xzlashutosh/avsddac_3v3/README.md

## 1. Introduction to Potentiometric Digital to Analog Converter
This repository presents a 10-bit Potentiometric Digital to Analog Converter.

The target is to design a 10-bit potentiometric DAC with 3.3v analog voltage and 1 off-chip external reference using the osu180nm technology node. Here are the specifications from [VSD Corporation Pvt. Ltd.](https://github.com/xzlashutosh/avsddac_3v3/blob/master/potentiometricDAC_IP.pdf)

A DAC is a building block required to convert digital data into analog.

## Table of Contents
- [1. Introduction to Potentiometric Digital to Analog Converter](#1-introduction-to-potentiometric-digital-to-analog-converter)
- [2. Potentiometric DAC Architecture Design](#2-potentiometric-dac-architecture-design)
- [3. Specification List](#3-specification-list)
- [4. EDA Tools Used](#4-eda-tools-used)
- [5. Pre-layout and Simulations](#5-pre-layout-and-simulations)
  * [A. Switch](#a-switch)
  * [B. 2-Bit DAC subcircuit](#b-2-bit-dac-subcircuit)
  * [C. 3-Bit DAC subcircuit](#c-3-bit-dac-subcircuit)
  * [D. 4-Bit DAC subcircuit](#d-4-bit-dac-subcircuit)
  * [E. 5-Bit DAC subcircuit](#e-5-bit-dac-subcircuit)
  * [F. 6-Bit DAC subcircuit](#f-6-bit-dac-subcircuit)
  * [G. 7-Bit DAC subcircuit](#g-7-bit-dac-subcircuit)
  * [H. 8-Bit DAC subcircuit](#h-8-bit-dac-subcircuit)
  * [I. 9-Bit DAC subcircuit](#i-9-bit-dac-subcircuit)
  * [J. 10-Bit-DAC](#j-10-bit-dac)
  * [Vout v/s Digital Code Graph for 10-Bit DAC](https://github.com/xzlashutosh/avsddac_3v3#vout-vs-digital-code-graph-for-10-bit-dac)
  * [INL(LSB) v/s Digital Code Graph for 10-Bit DAC](https://github.com/xzlashutosh/avsddac_3v3#inllsb-vs-digital-code-graph-for-10-bit-dac)
  * [DNL(LSB) v/s Digital Code Graph for 10-Bit DAC](https://github.com/xzlashutosh/avsddac_3v3#dnllsb-vs-digital-code-graph-for-10-bit-dac)
- [6. Layout and Simulations](#6-layout-and-simulations)
  * [A. Switch Layout](#a-switch-layout)
  * [B. Resistor Layout](#b-resistor-layout)
  * [C. Capacitor Layout](#c-capacitor-layout)
    + [Modification done in osu180nm to make use of a capacitor as a device -](#modification-done-in-osu180nm-to-make-use-of-a-capacitor-as-a-device--)
    + [Limitation of osu180 PDK -](#limitation-of-osu180-pdk--)
  * [D. 2-Bit DAC Subcircuit Layout](#d-2-bit-dac-subcircuit-layout)
  * [E. 3-Bit DAC Subcircuit Layout](#e-3-bit-dac-subcircuit-layout)
  * [F. 4-Bit DAC Subcircuit Layout](#f-4-bit-dac-subcircuit-layout)
  * [G. 5-Bit DAC Subcircuit Layout](#g-5-bit-dac-subcircuit-layout)
  * [H. 6-Bit DAC Subcircuit Layout](#h-6-bit-dac-subcircuit-layout)
  * [I. 7-Bit DAC Subcircuit Layout](#i-7-bit-dac-subcircuit-layout)
  * [J. 8-Bit DAC Subcircuit Layout](#j-8-bit-dac-subcircuit-layout)
  * [K. 9-Bit DAC Subcircuit Layout](#k-9-bit-dac-subcircuit-layout)
  * [L. 10-Bit-DAC Layout](#l-10-bit-dac-layout)
  * [Vout v/s Digital Code Graph for 10-Bit DAC](#vout-v-s-digital-code-graph-for-10-bit-dac-1)
  * [INL(LSB) v/s Digital Code Graph for 10-Bit DAC](#inl-lsb--v-s-digital-code-graph-for-10-bit-dac-1)
  * [DNL(LSB) v/s Digital Code Graph for 10-Bit DAC](#dnl-lsb--v-s-digital-code-graph-for-10-bit-dac-1)
- [7. Instructions to get started with the design](#7-instructions-to-get-started-with-the-design)
  * [For Pre-Layout Simulation -](#for-pre-layout-simulation--)
  * [For Post-Layout Simulation -](#for-post-layout-simulation--)
- [8. Author](#8-author)
- [9. Acknowledgments](#9-acknowledgments)
- [10. Contact Information -](#10-contact-information--)

## 2. Potentiometric DAC Architecture Design

The basic idea is to divide the voltage into N different voltage values in the range of Vref+ and Vref- for an N-Bit DAC. The design used here to achieve this is the simple resistor string DAC which consists of resistors in series. These resistors are then connected to various switches in such a fashion that it routes the exact voltage to the output.

The problem of the largeness of the circuit is reduced by building hierarchical subcircuits of switch, 2 Bit, 3 Bit, 4 Bit,....., 9 Bit DAC, and then two 9 Bit DAC is used to build the 10-Bit potentiometric DAC.

Have a look at the simplified architecture for potentiometric-DAC given below

<p align="center">
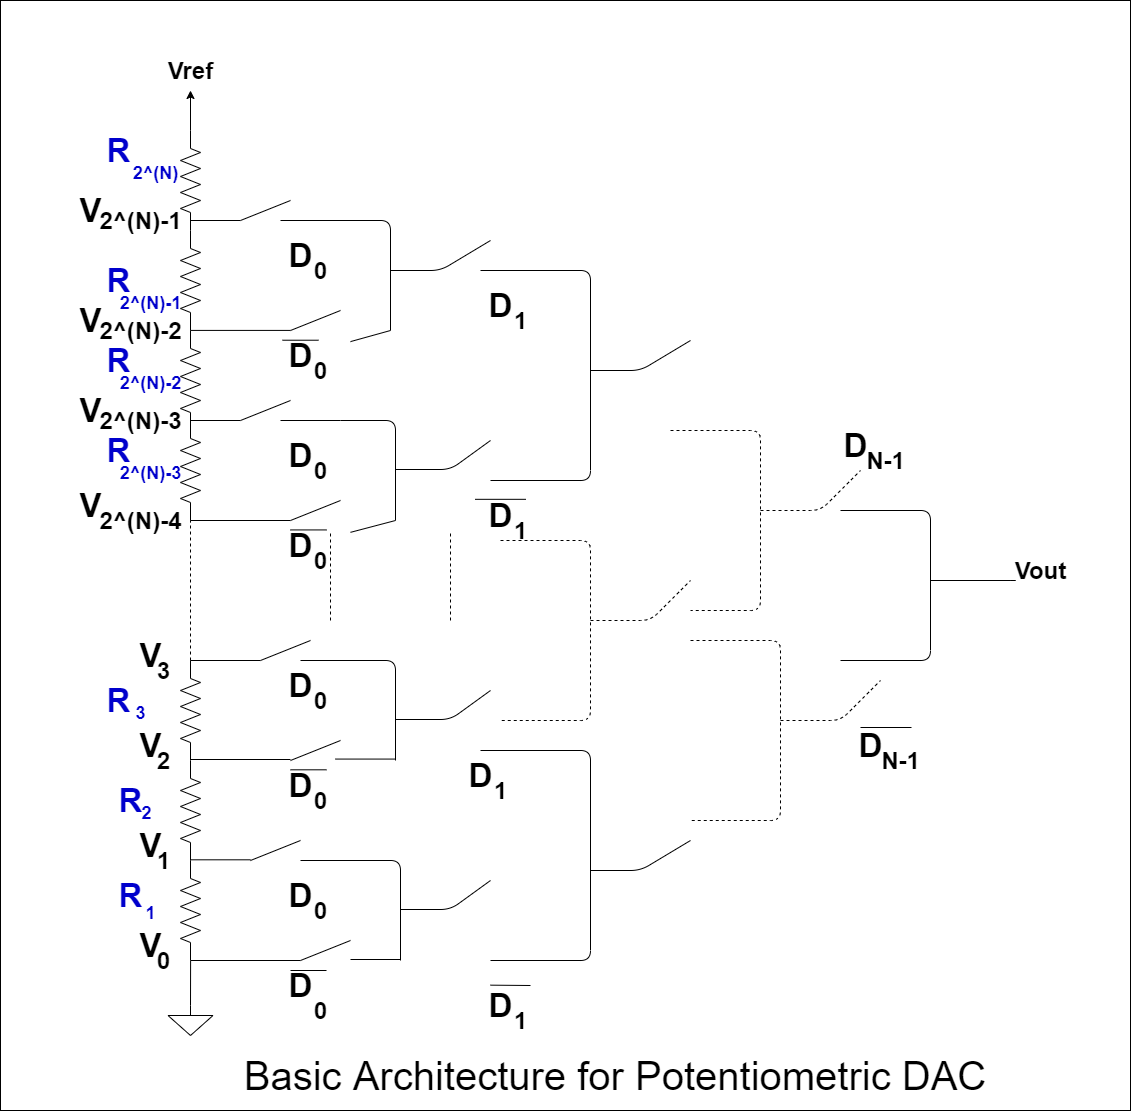
[picture p1: subcircuits/An overview of 10-Bit PotDAC.png]
  
</p>

Given below is the block diagram of the DAC - 

<p align="center">
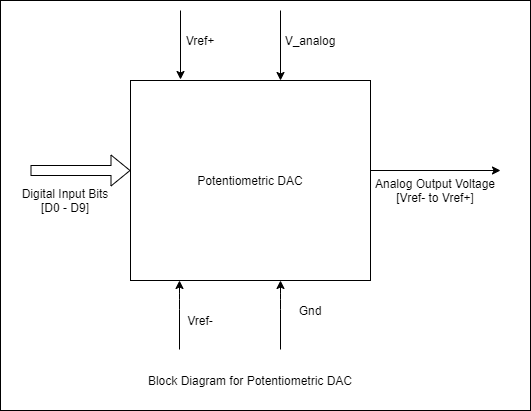
[picture p2: subcircuits/overview of design.png]
  
</p>

## 3. Specification List

| Parameter| Description| Min | Type | Max | Unit | Condition |
| :---:  | :-: | :-: | :-: | :---:  | :-: | :-: |
|RL|Load resistance| 50|||Mohm|T=-40 to 85C|
|CL|Load capacitance|||1|pF|T=-40 to 85C|
|VDDA|Analog supply| |3.3||V|T=-40 to 85C|
|VDD|Digital supply voltage||1.8||V|T=-40 to 85C|
|VREFH|Reference voltage high|||3.3|V|T=-40 to 85C|
|VREFL|Reference voltage low|0|||V|T=-40 to 85C|
|RES|Resolution| |10||bit|T=27C|
|VFS|Full Scale Voltage|0| |3.291627| V |T=27C|

| Parameter| Pre-layout | Post-Layout |
| :---:  | :-: | :-: |
|DNL| -0.999893345 LSB to 2.03065020 LSB | -1.182952606 LSB to 2.380283181 LSB |
|INL| -1.953038429 LSB to 0.527216491 LSB| -3.698306813 LSB to 0.181125461 LSB |
|Gain Error| 0 | 0 |
|Offset Error| 2.12E-07 V | 2.14E-07 V |

## 4. EDA Tools Used 
The design has been built using open-source EDA tools. The library used is osu180nm. 

I have used [eSim](https://esim.fossee.in/downloads) to build schematic, [ngSpice](http://ngspice.sourceforge.net/download.html) to run simulations and verify the circuit. [Magic](http://opencircuitdesign.com/magic/) has been used to lay-out the circuit.

## 5. Pre-layout and Simulations
The complete circuit of 10-Bit potentiometric DAC is built hierarchically using the following subcircuits.

### A. Switch
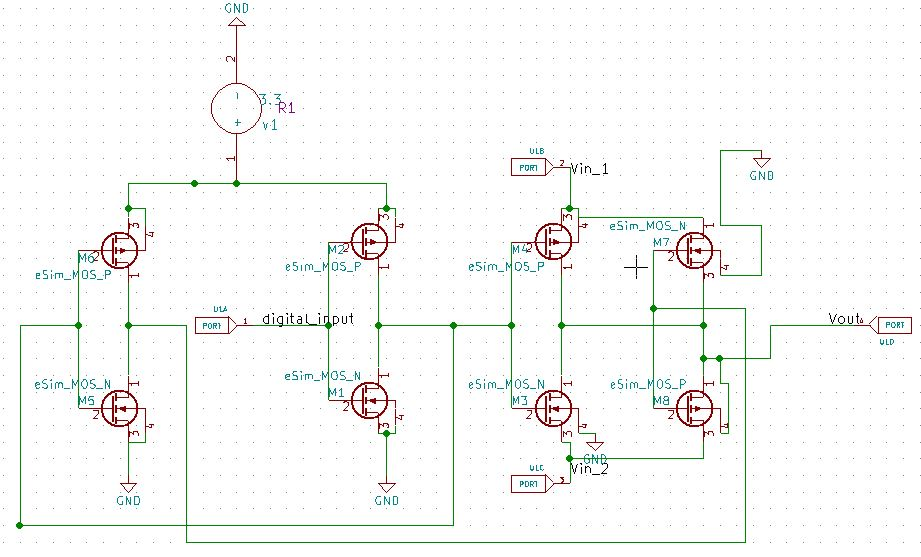
[picture p3: Pre-Layout and Simulation/Switch - prelayout.JPG]


### B. 2-Bit DAC subcircuit
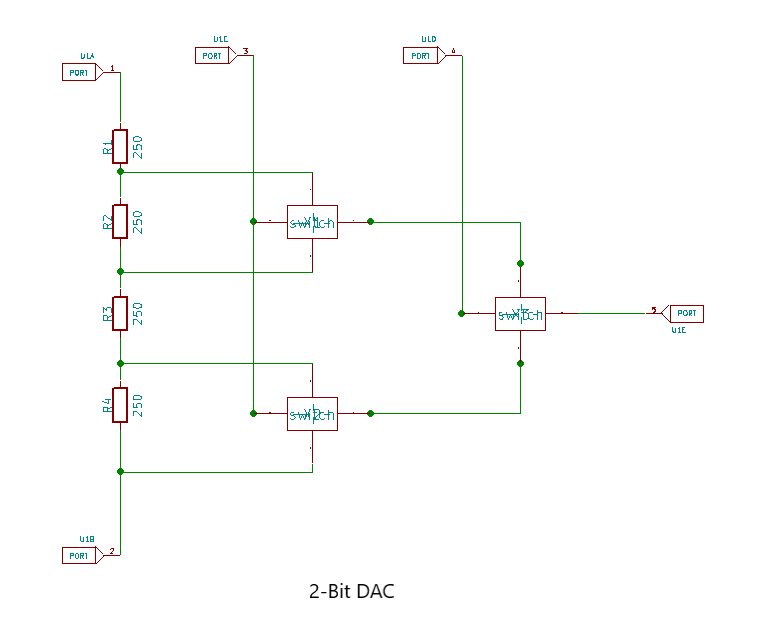
[picture p4: subcircuits/2-Bit_DAC.png]


### C. 3-Bit DAC subcircuit
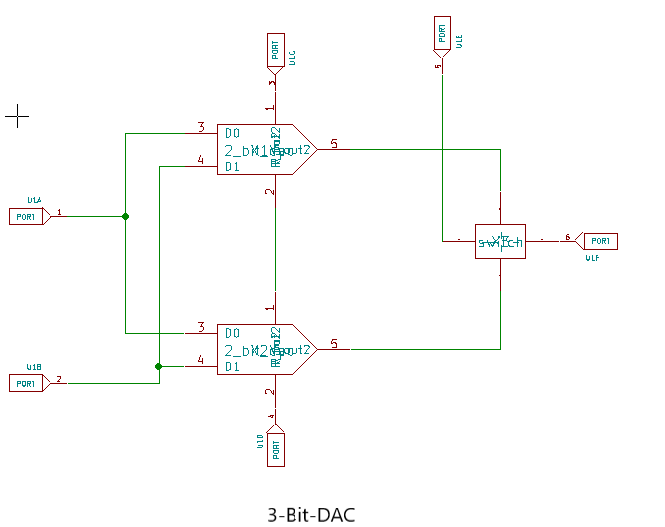
[picture p5: subcircuits/3-bit_DAC.png]


### D. 4-Bit DAC subcircuit
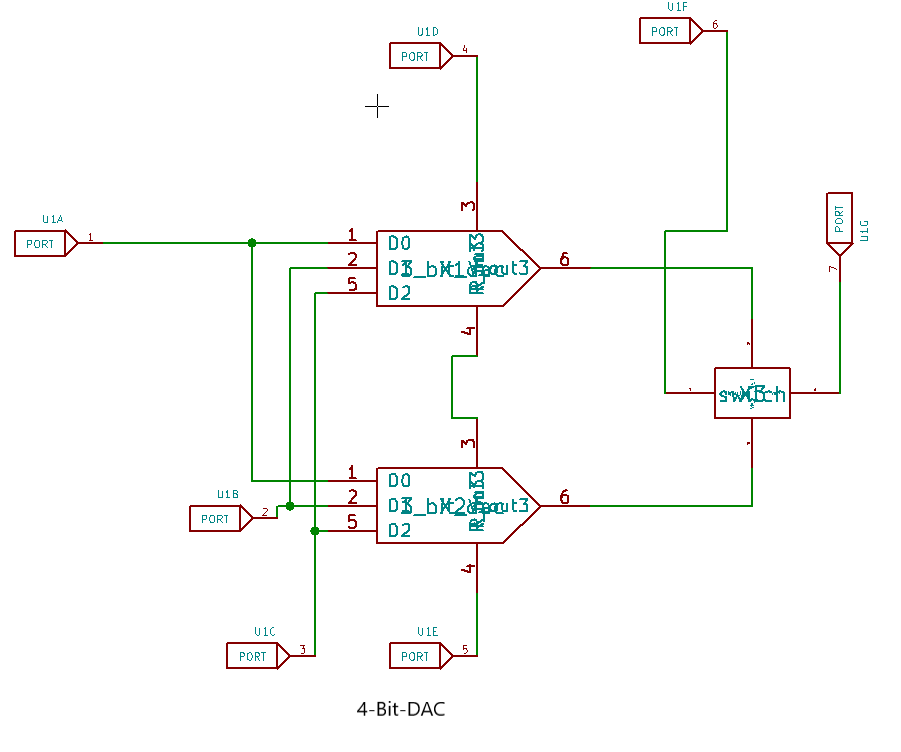
[picture p6: subcircuits/4-bitDAC.png]


### E. 5-Bit DAC subcircuit
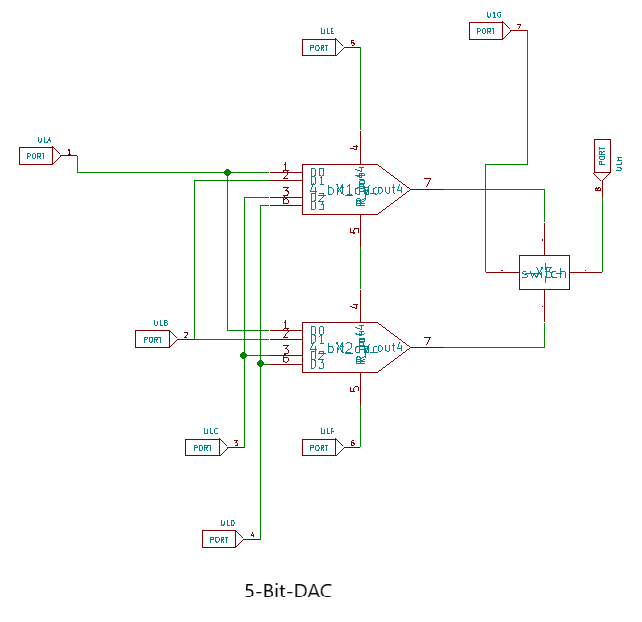
[picture p7: subcircuits/5_bit_dac.png]


### F. 6-Bit DAC subcircuit
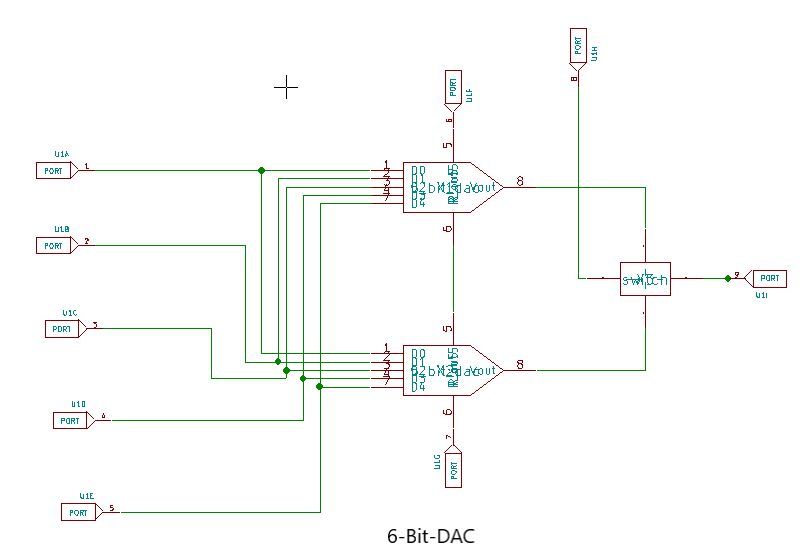
[picture p8: subcircuits/6_bit_dac.png]


### G. 7-Bit DAC subcircuit
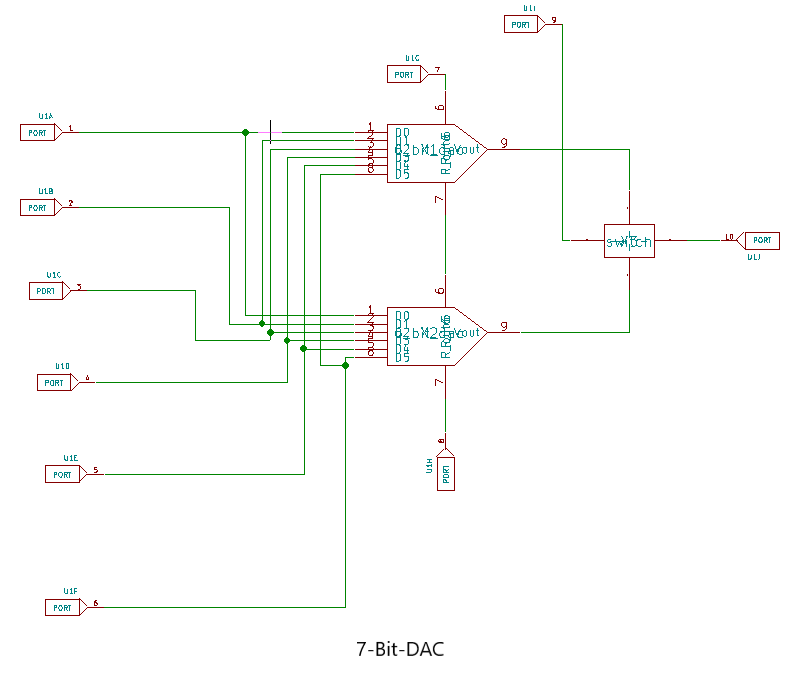
[picture p9: subcircuits/7_bit_dac.png]


### H. 8-Bit DAC subcircuit
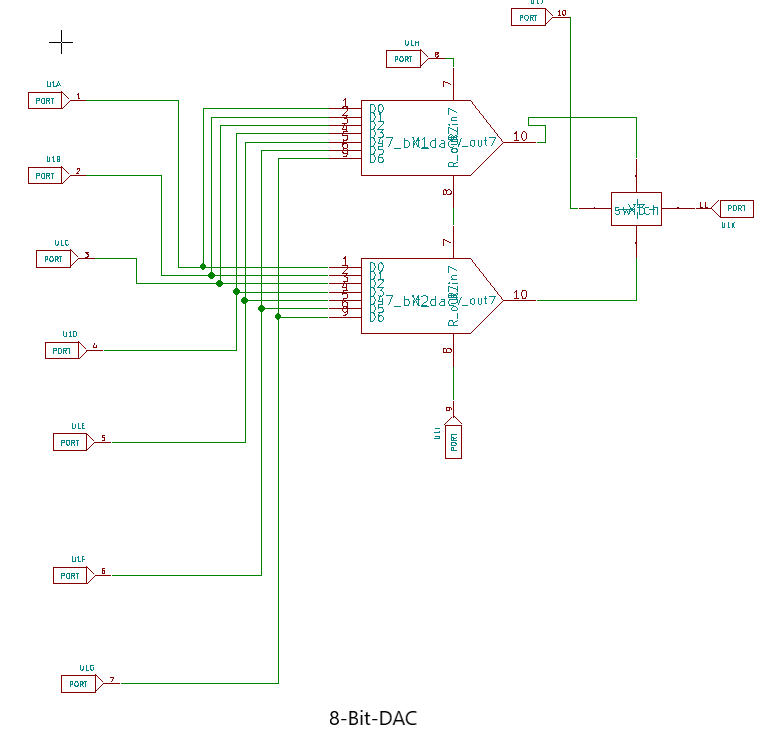
[picture p10: subcircuits/8_bit_dac.png]


### I. 9-Bit DAC subcircuit
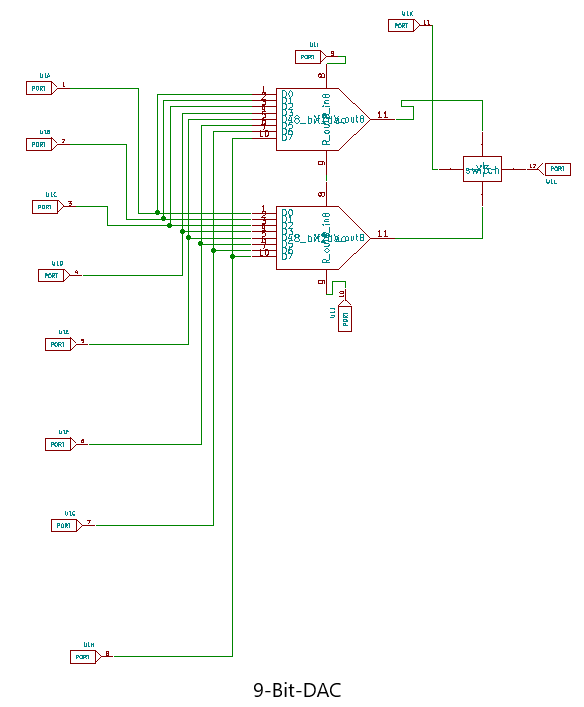
[picture p11: subcircuits/9_bit_dac.png]


### J. 10-Bit-DAC
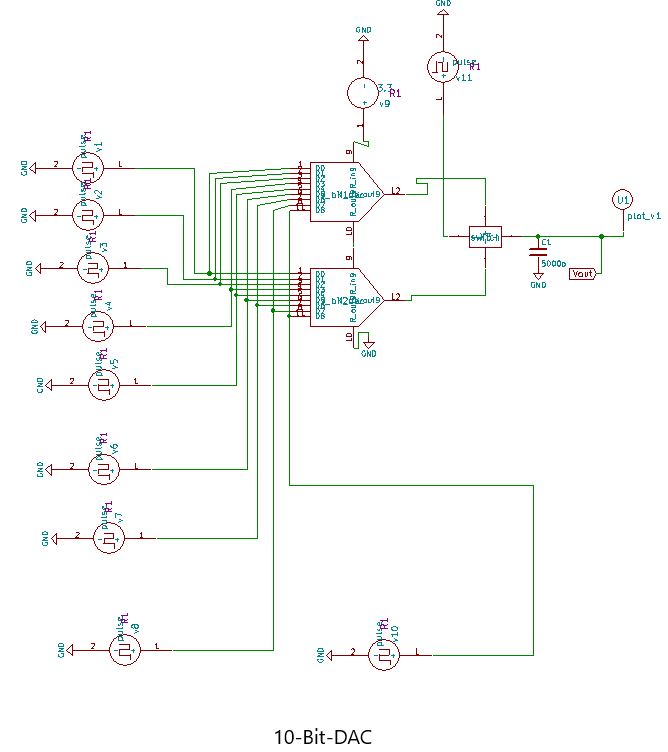
[picture p12: subcircuits/10_bit_dac.png]


#### The source details at Vref+ = 3.3V and Vref- = 0V are given [here](https://github.com/xzlashutosh/avsddac_3v3/blob/master/Pre-Layout%20and%20Simulation/SourceDetails.txt).

### Vout v/s Digital Code Graph for 10-Bit DAC

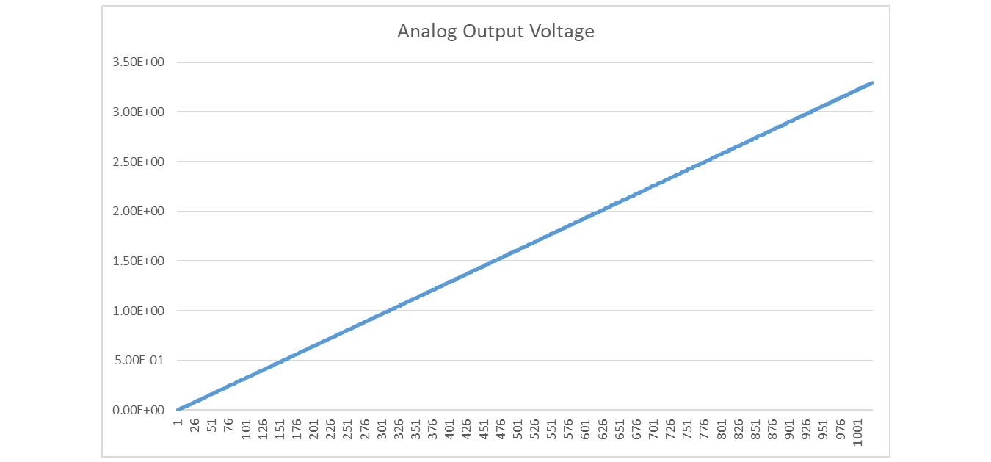
[picture p13: Pre-Layout and Simulation/prelayout - output waveform.png]


### INL(LSB) v/s Digital Code Graph for 10-Bit DAC

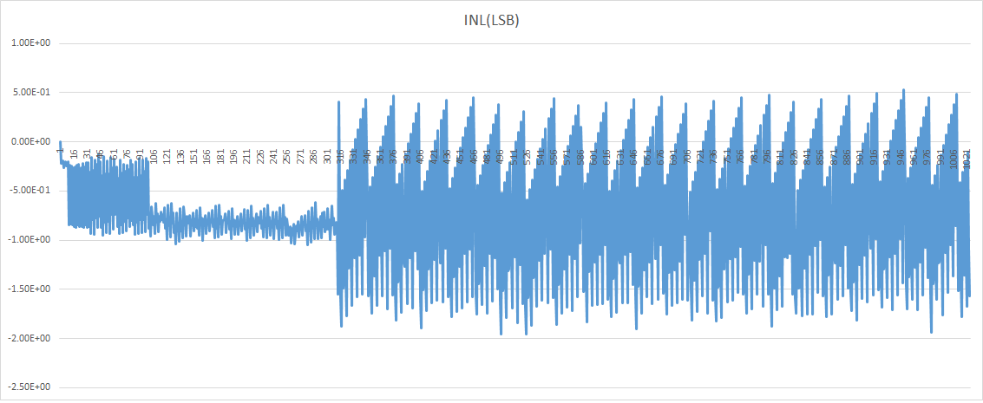
[picture p14: Pre-Layout and Simulation/INL(LSB).png]


### DNL(LSB) v/s Digital Code Graph for 10-Bit DAC

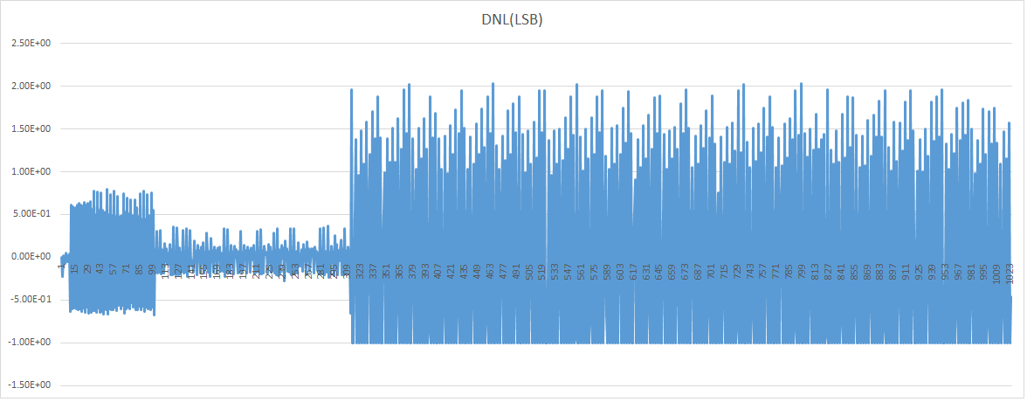
[picture p15: Pre-Layout and Simulation/DNL(LSB).png]


### For pre-layout simulation please follow [this](https://github.com/xzlashutosh/avsddac_3v3#for-pre-layout-simulation--).

## 6. Layout and Simulations 

### A. Switch Layout
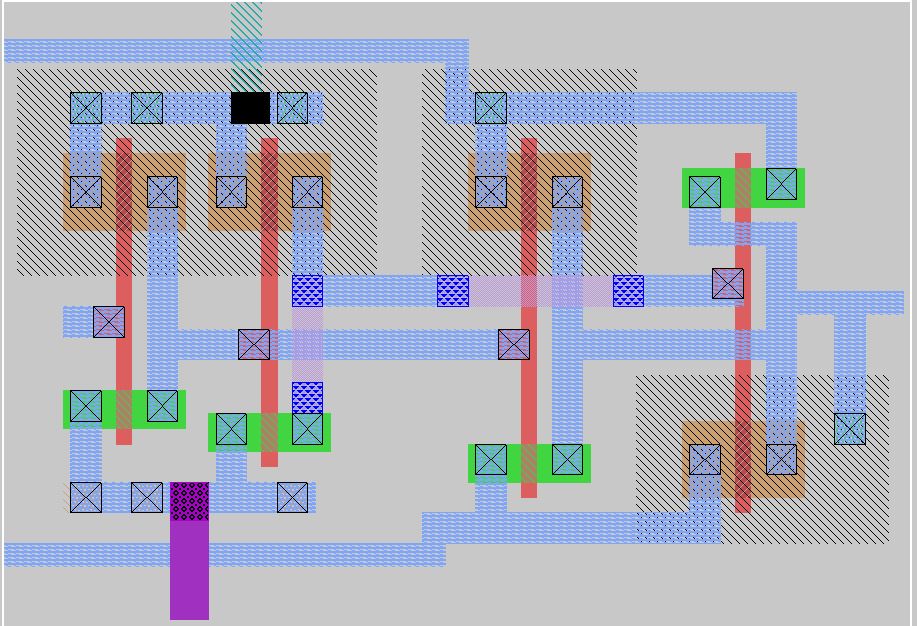
[picture p16: Layout and Simulation/LayoutImages/sw.JPG]


### B. Resistor Layout
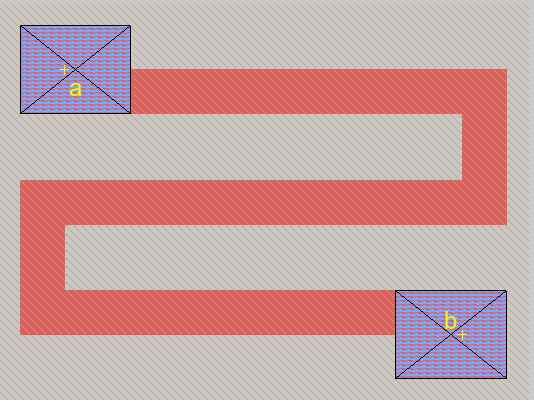
[picture p17: Layout and Simulation/LayoutImages/resistor.JPG]


value = 253 Ω

### C. Capacitor Layout
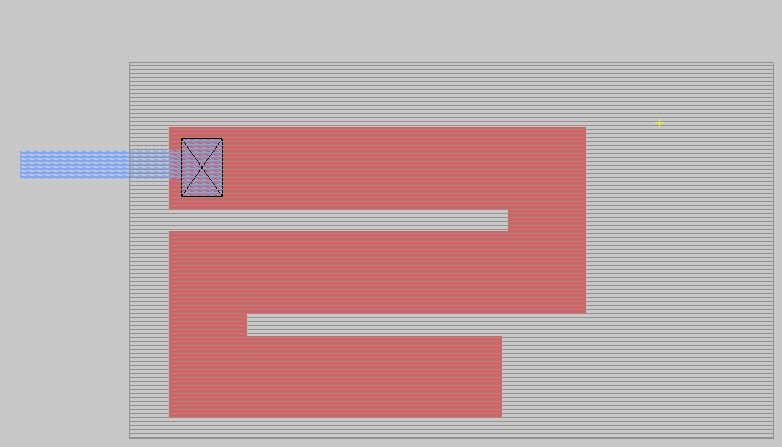
[picture p18: Layout and Simulation/LayoutImages/capacitor.JPG]


value = 3.12nF

#### Modification done in osu180nm to make use of a capacitor as a device - 
 add 
 
        device capacitor None glass poly,pc 9000 73000 

in the #devices section inside the osu180nm.tech node.

#### Limitation of osu180 PDK - 
As the capacitor layer, or poly2 none are present in osu180nm, the capacitor can not be built in a straight forward way using the osu PDK.The above given modifications in the technology node were done to simulate the characteristics of the circuit. Here, defining the capacitor in a certain manner gives the required characteristics in the circuit.

### D. 2-Bit DAC Subcircuit Layout
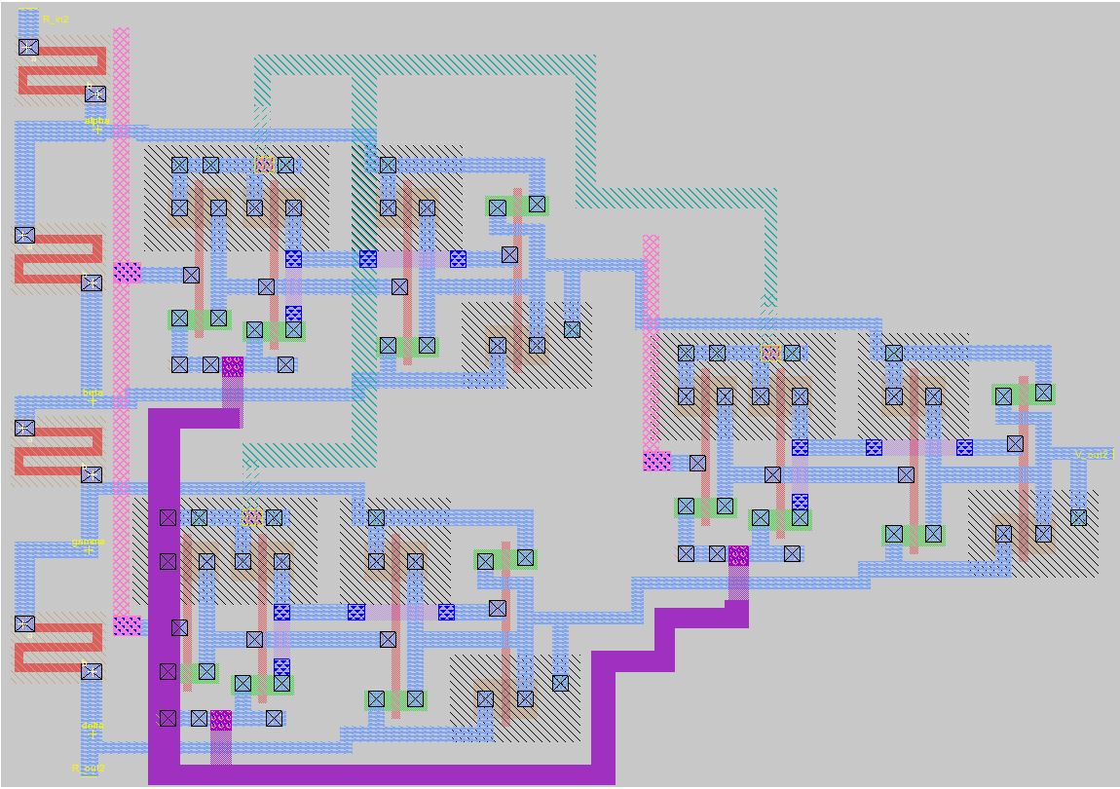
[picture p19: Layout and Simulation/LayoutImages/2.JPG]


### E. 3-Bit DAC Subcircuit Layout
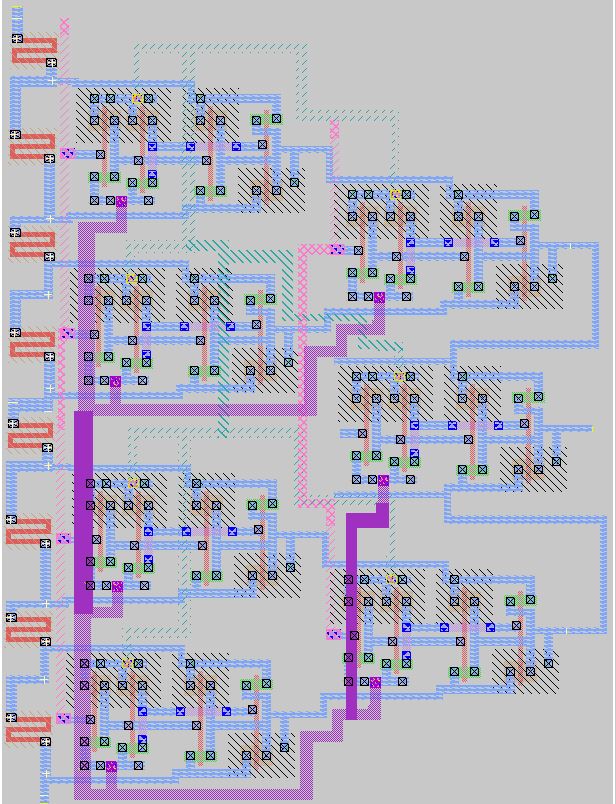
[picture p20: Layout and Simulation/LayoutImages/3.JPG]


### F. 4-Bit DAC Subcircuit Layout
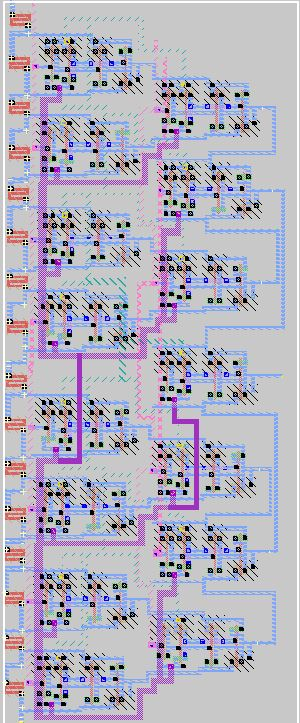
[picture p21: Layout and Simulation/LayoutImages/4.JPG]


### G. 5-Bit DAC Subcircuit Layout
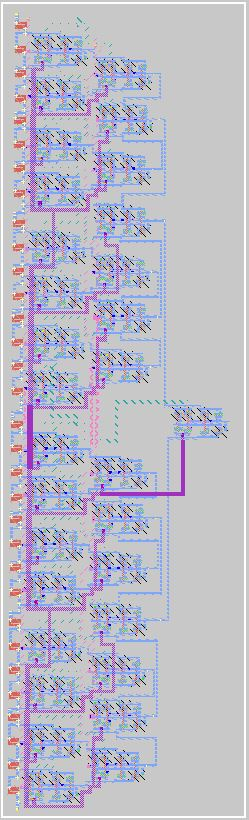
[picture p22: Layout and Simulation/LayoutImages/5.JPG]


### H. 6-Bit DAC Subcircuit Layout
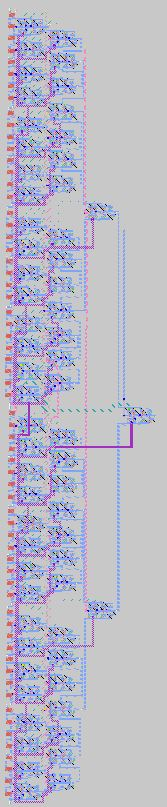
[picture p23: Layout and Simulation/LayoutImages/6.JPG]


### I. 7-Bit DAC Subcircuit Layout
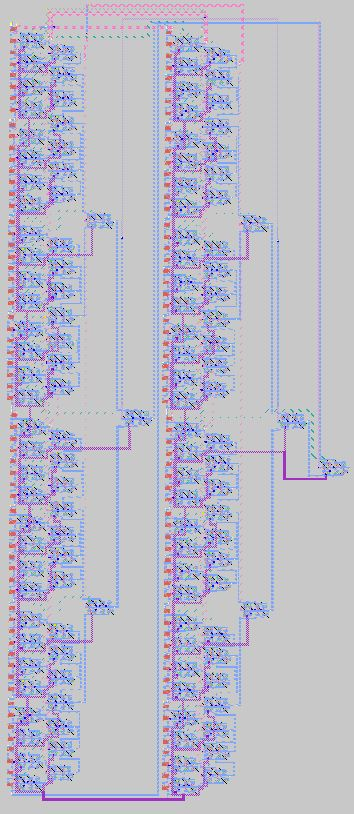
[picture p24: Layout and Simulation/LayoutImages/7.JPG]


### J. 8-Bit DAC Subcircuit Layout
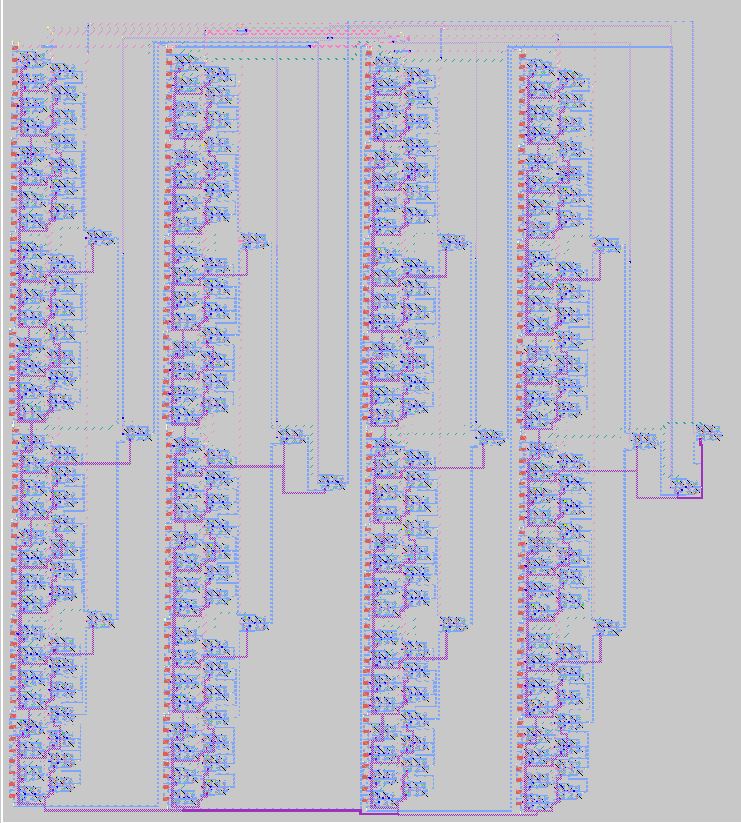
[picture p25: Layout and Simulation/LayoutImages/8.JPG]


### K. 9-Bit DAC Subcircuit Layout
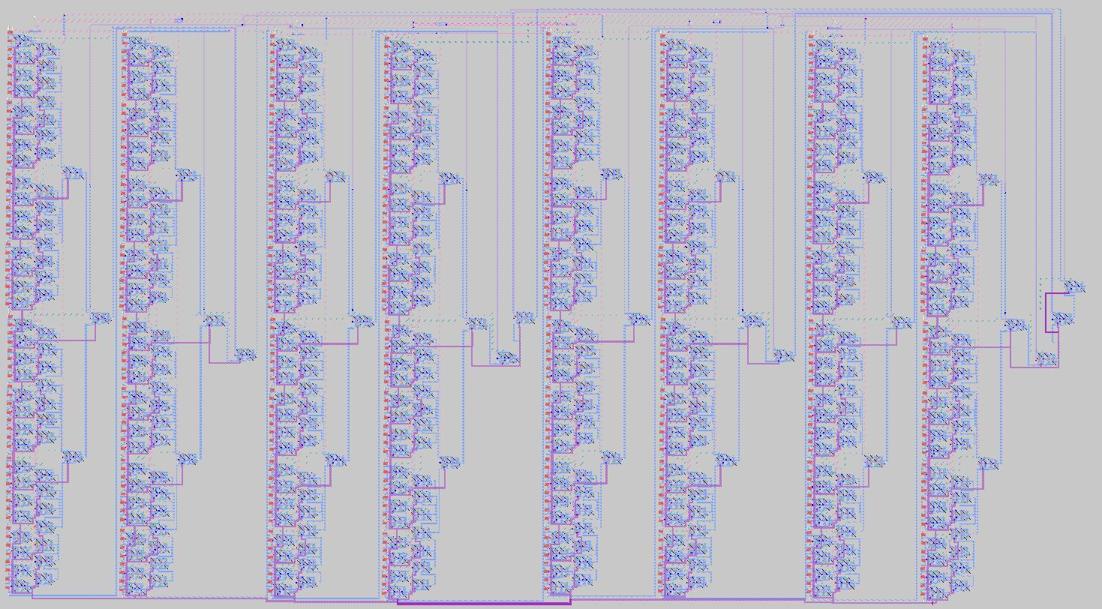
[picture p26: Layout and Simulation/LayoutImages/9.JPG]


### L. 10-Bit-DAC Layout
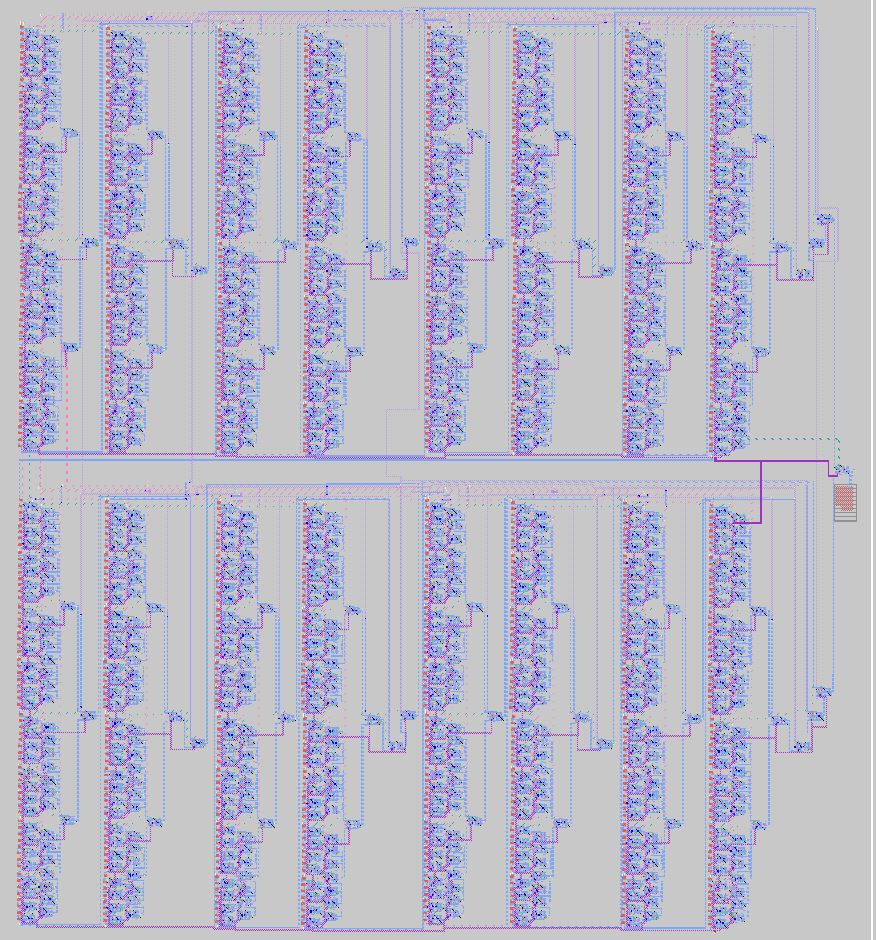
[picture p27: Layout and Simulation/LayoutImages/10.JPG]


size = 635.1 x 684.8 microns

#### The source details are [here](https://github.com/xzlashutosh/avsddac_3v3/blob/master/Layout%20and%20Simulation/toPasteInEnd.txt).

### Vout v/s Digital Code Graph for 10-Bit DAC

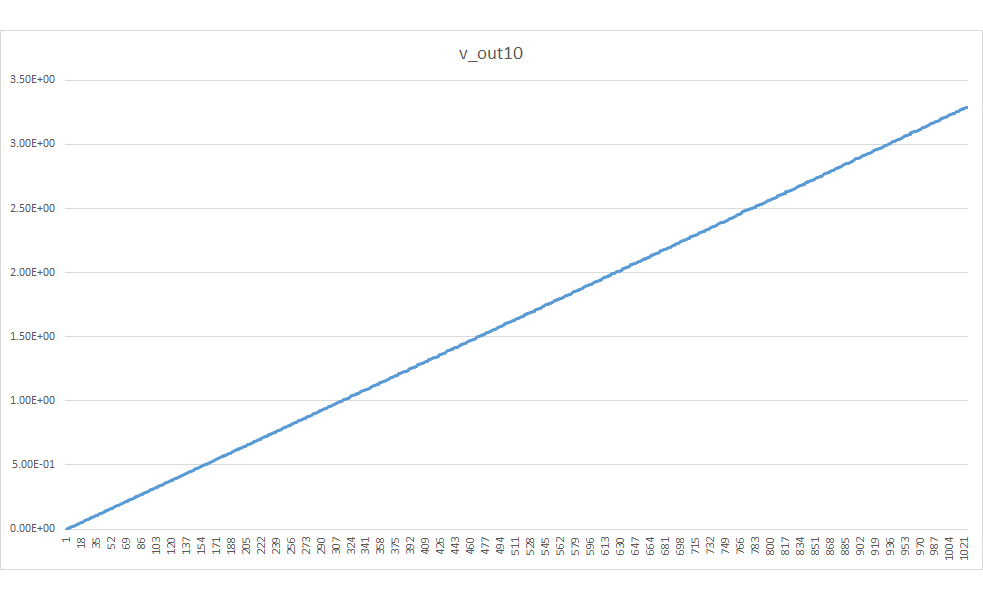
[picture p28: Layout and Simulation/OutputWaveform.png]


### INL(LSB) v/s Digital Code Graph for 10-Bit DAC

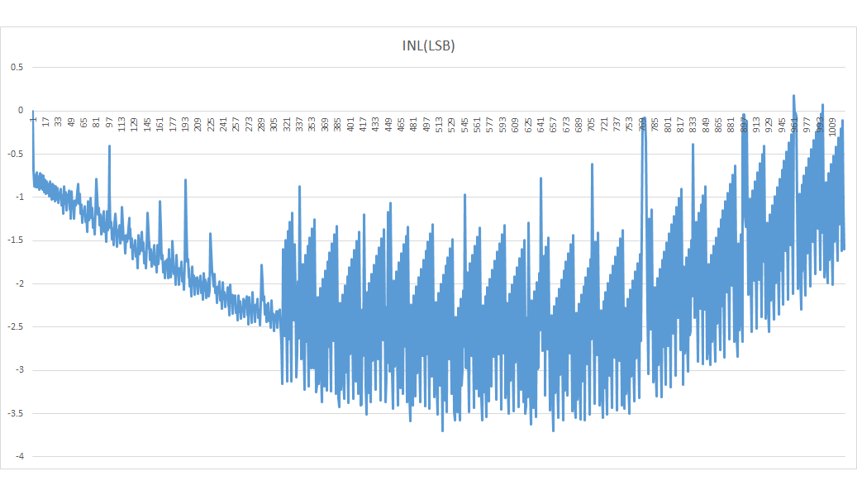
[picture p29: Layout and Simulation/INL(LSB)-postLayout.png]


### DNL(LSB) v/s Digital Code Graph for 10-Bit DAC

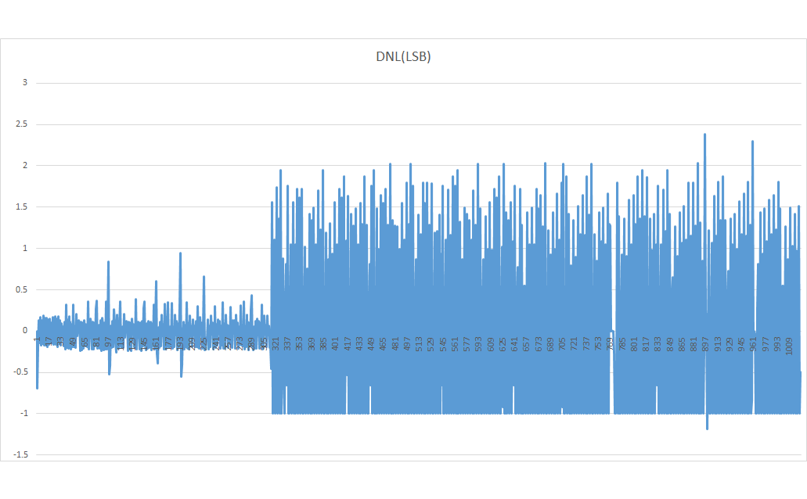
[picture p30: Layout and Simulation/DNL(LSB)-postLayout.png]


### For post-layout simulation please follow [this](https://github.com/xzlashutosh/avsddac_3v3#for-post-layout-simulation--).

## 7. Instructions to get started with the design
### For Pre-Layout Simulation - 
1. Download eSim from the given [website](https://esim.fossee.in/downloads).
2. Download [this](https://github.com/xzlashutosh/avsddac_3v3/tree/master/Pre-Layout%20and%20Simulation) folder.
3. Keep the contents of [subcircuits folder](https://github.com/xzlashutosh/avsddac_3v3/tree/master/subcircuits) inside the eSim subcircuits folder (C:\FOSSEE\eSim\library\SubcircuitLibrary).
4. Store the [libary files](https://github.com/xzlashutosh/avsddac_3v3/tree/master/Libraries) in the eSim User Library section (C:\FOSSEE\eSim\library\deviceModelLibrary\User Libraries).
5. Open the 10_bit_dac project in eSim kept in Pre-Layout Simulation [folder ](https://github.com/xzlashutosh/avsddac_3v3/tree/master/Pre-Layout%20and%20Simulation).
6. Run the schematic, extract spice netlist, and simulate the design using ngSpice to view the output. You should get the output as shown above in the [figure](https://github.com/xzlashutosh/potentiometric-DAC/blob/master/subcircuits/10_bit_dac.png).

The simulation may take more than an hour to complete. Kindly keep patience.

### For Post-Layout Simulation - 
1. Download Magic from the given [website](http://opencircuitdesign.com/magic/) for Linux and Mac.
For windows, you will have to install Cygwin Terminal and then Magic can run on the Windows platform also. Kindly look [here](http://opencircuitdesign.com/cygwin/magic.html) for Windows operating system. 

2. Download [this](https://github.com/xzlashutosh/avsddac_3v3/tree/master/Layout%20and%20Simulation) folder or complete repository.
3. Go to the specific directory to run the Magic file.
4. To open the 10BitDac.mag with osu180nm.tech using terminal type - 
       magic -T osu180nm.tech 10BitDac
5. To extract the spice netlist type in tkcon window -

       extract all
       ext2spice 10BitDac.ext
     
6. After you get the extracted netlist, to add the contents of [this](https://github.com/xzlashutosh/avsddac_3v3/blob/master/Layout%20and%20Simulation/toPasteInStarting.txt) file at the beginning of the spice file, and also add the contents of [this](https://github.com/xzlashutosh/avsddac_3v3/blob/master/Layout%20and%20Simulation/toPasteInEnd.txt) file at the end of the spice file to append the pmos,nmos libraries, and simulation parameters.
7. Now, to simulate the layout, run ngspice in another terminal using -

       ngspice 10BitDac.spice
       
8. You should get the output as shown above in the [figure](https://github.com/xzlashutosh/avsddac_3v3/blob/master/Layout%20and%20Simulation/OutputWaveform.png).
  
## 8. Author 
- Ashutosh Sharma, B.Tech, Electronics & Communication Engineering, IIITD&M Kurnool

## 9. Acknowledgments
- Kunal Ghosh, Co-founder VSD Corp. Pvt. Ltd.
- Philipp Gühring, Software Architect, LibreSilicon Association.

I would also like to thank research fellows for extending their help and guidance during the research internship program. Many Thanks to 

- Ankur Sah, M.tech Embedded Systems, NIT Jamshedpur, ankursah5@gmail.com
- Nikhil Shinde, B.E., KJSIEIT Mumbai, shinde.nv@somaiya.edu
- Shubham Negi, B.Tech. Computer Engineering, IIITD&M Kurnool, coe17b030@iiitk.ac.in
- Sheryl Serrao, Undergraduate Student, Mumbai University, sherylcorina@gmail.com

## 10. Contact Information - 
 - Ashutosh Sharma, B.Tech, Electronics, and Communication Engineering, IIITD&M Kurnool, xzlashutosh@gmail.com
 - Kunal Ghosh, Co-founder, VSD Corp. Pvt. Ltd. - kunalghosh@gmail.com
 - Philipp Gühring, Software Architect, LibreSilicon Association - pg@futureware.at
