xzlashutosh/avsddac_3v3/subcircuits/readme.md

Here we have all the subcircuits used to make a 10-bit digital to analog converter for the pre-layout stage which are built using eSim.
