xzlashutosh/avsddac_3v3/Layout and Simulation/Layout.png

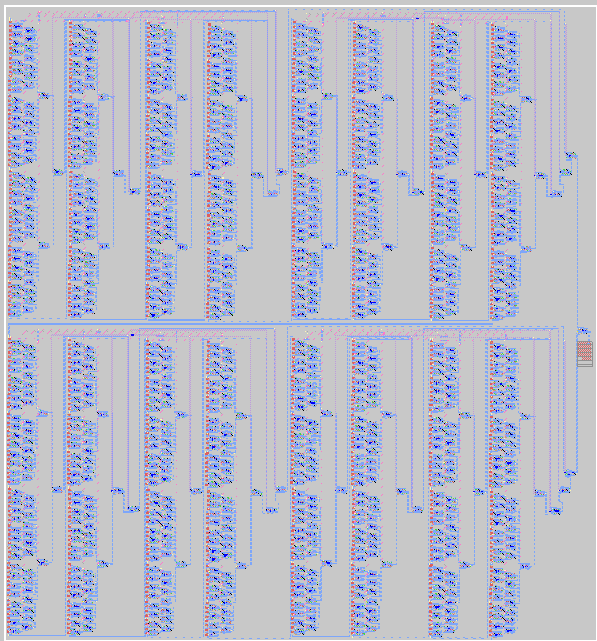
Layout and Simulation/Layout.png
