xzlashutosh/avsddac_3v3/Layout and Simulation/Output Waveform with 3nF capacitor2-ngspice.png

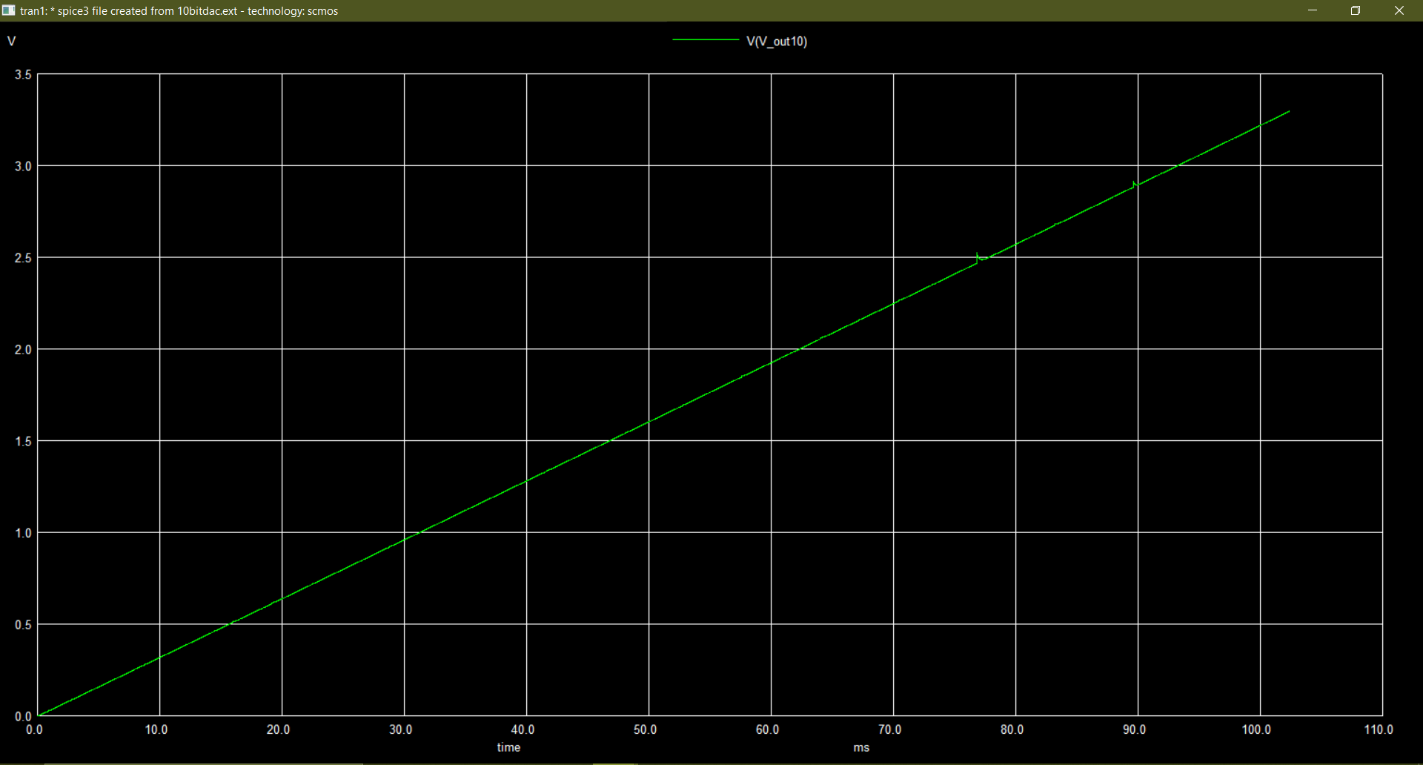
Layout and Simulation/Output Waveform with 3nF capacitor2-ngspice.png
