xzlashutosh/avsddac_3v3/Pre-Layout and Simulation/2_bit_dac.sch

## KiCad design Pre-Layout and Simulation/2_bit_dac.sch (2020-08-22)

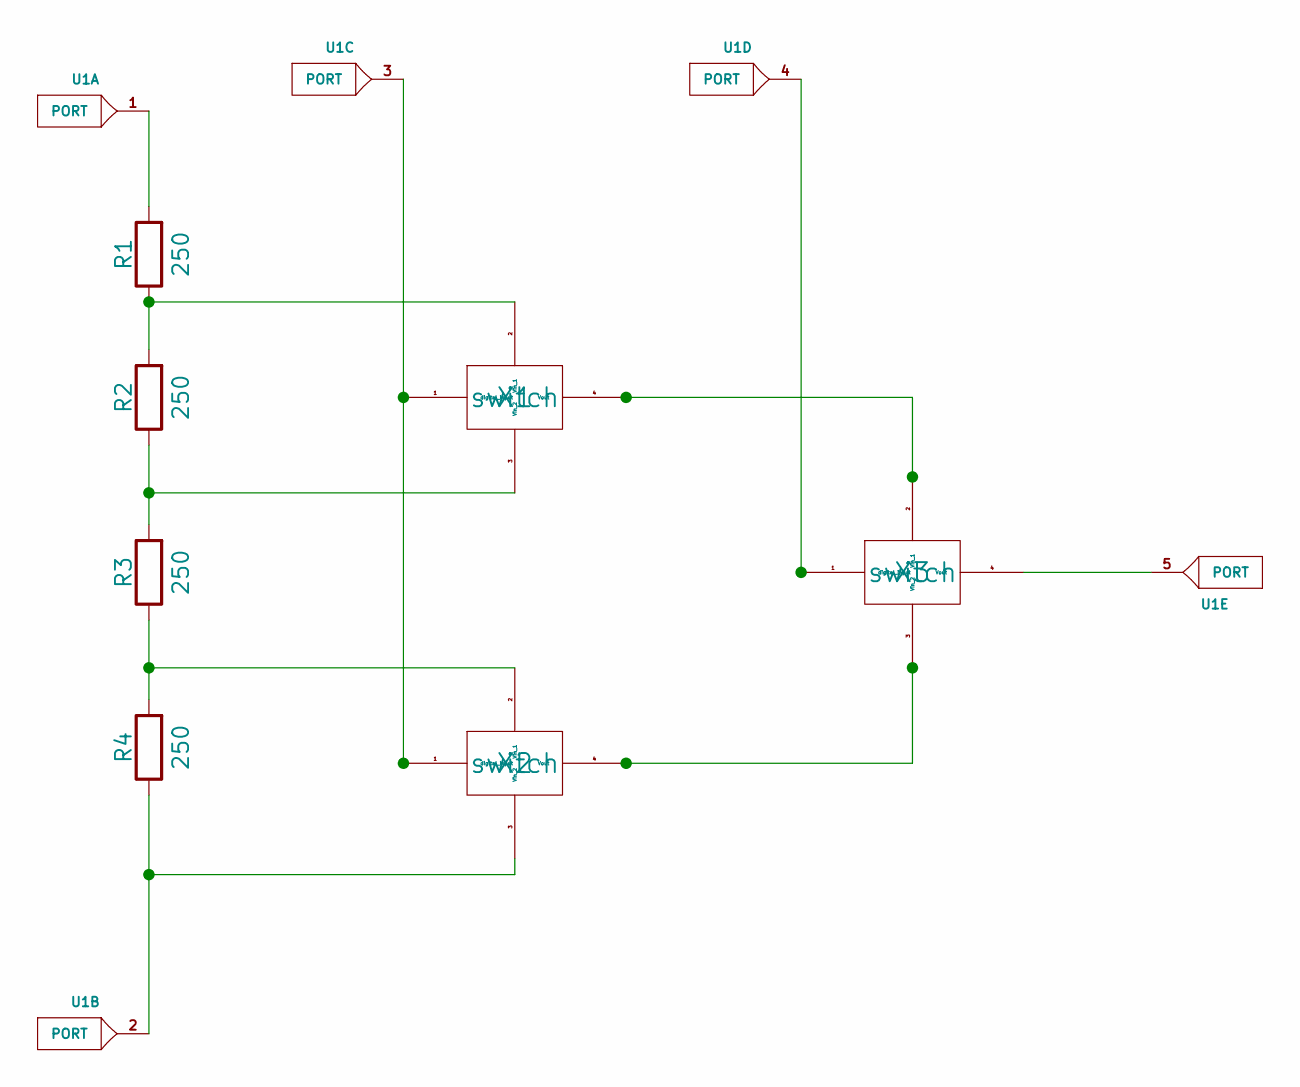
[picture p34: schematic 2_bit_dac.sch]

Parts:
R1, R2, R3, R4: 250
U1: PORT
X1, X2, X3: switch

Connections:
unnamed: R1.1, R2.2, X1.2 (Vin_1)
unnamed: R1.2, U1.1
unnamed: R2.1, R3.2, X1.3 (Vin_2)
unnamed: R3.1, R4.2, X2.2 (Vin_1)
unnamed: R4.1, U1.2, X2.3 (Vin_2)
unnamed: U1.3, X1.1 (digital_input), X2.1 (digital_input)
unnamed: U1.4, X3.1 (digital_input)
unnamed: U1.5, X3.4 (Vout)
unnamed: X1.4 (Vout), X3.2 (Vin_1)
unnamed: X2.4 (Vout), X3.3 (Vin_2)
