xzlashutosh/avsddac_3v3/Pre-Layout and Simulation/3_bit_dac.sch

## KiCad design Pre-Layout and Simulation/3_bit_dac.sch (2020-08-22)

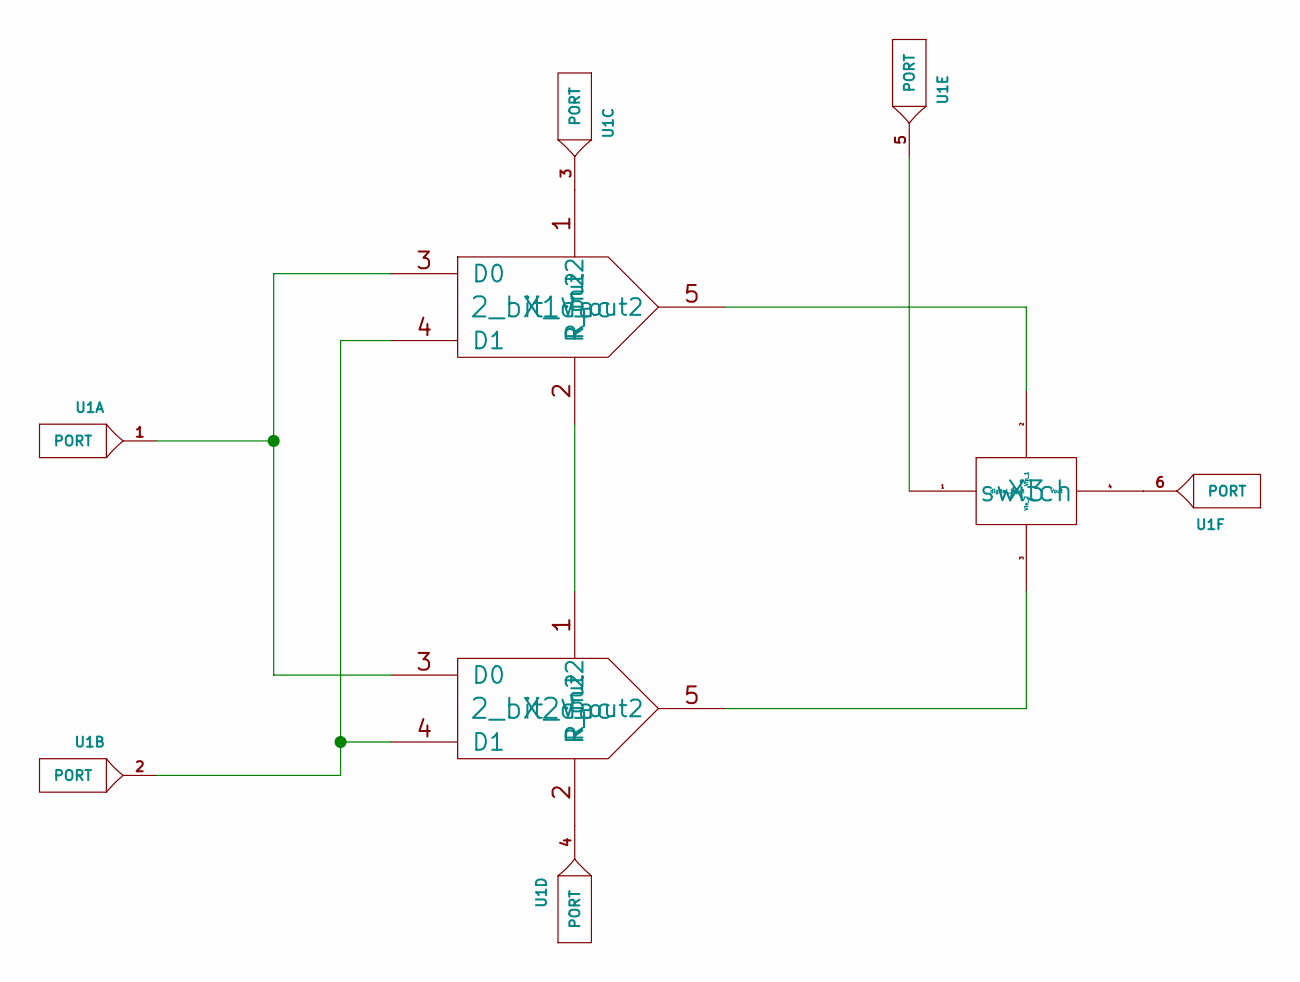
[picture p35: schematic 3_bit_dac.sch]

Parts:
U1: PORT
X1, X2: 2_bit_dac
X3: switch

Connections:
unnamed: U1.1, X1.3 (D0), X2.3 (D0)
unnamed: U1.2, X1.4 (D1), X2.4 (D1)
unnamed: U1.3, X1.1 (R_in2)
unnamed: U1.4, X2.2 (R_out2)
unnamed: U1.5, X3.1 (digital_input)
unnamed: U1.6, X3.4 (Vout)
unnamed: X1.2 (R_out2), X2.1 (R_in2)
unnamed: X1.5 (V_out2), X3.2 (Vin_1)
unnamed: X2.5 (V_out2), X3.3 (Vin_2)
