xzlashutosh/avsddac_3v3/Pre-Layout and Simulation/4_bit_dac.sch

## KiCad design Pre-Layout and Simulation/4_bit_dac.sch (2020-08-22)

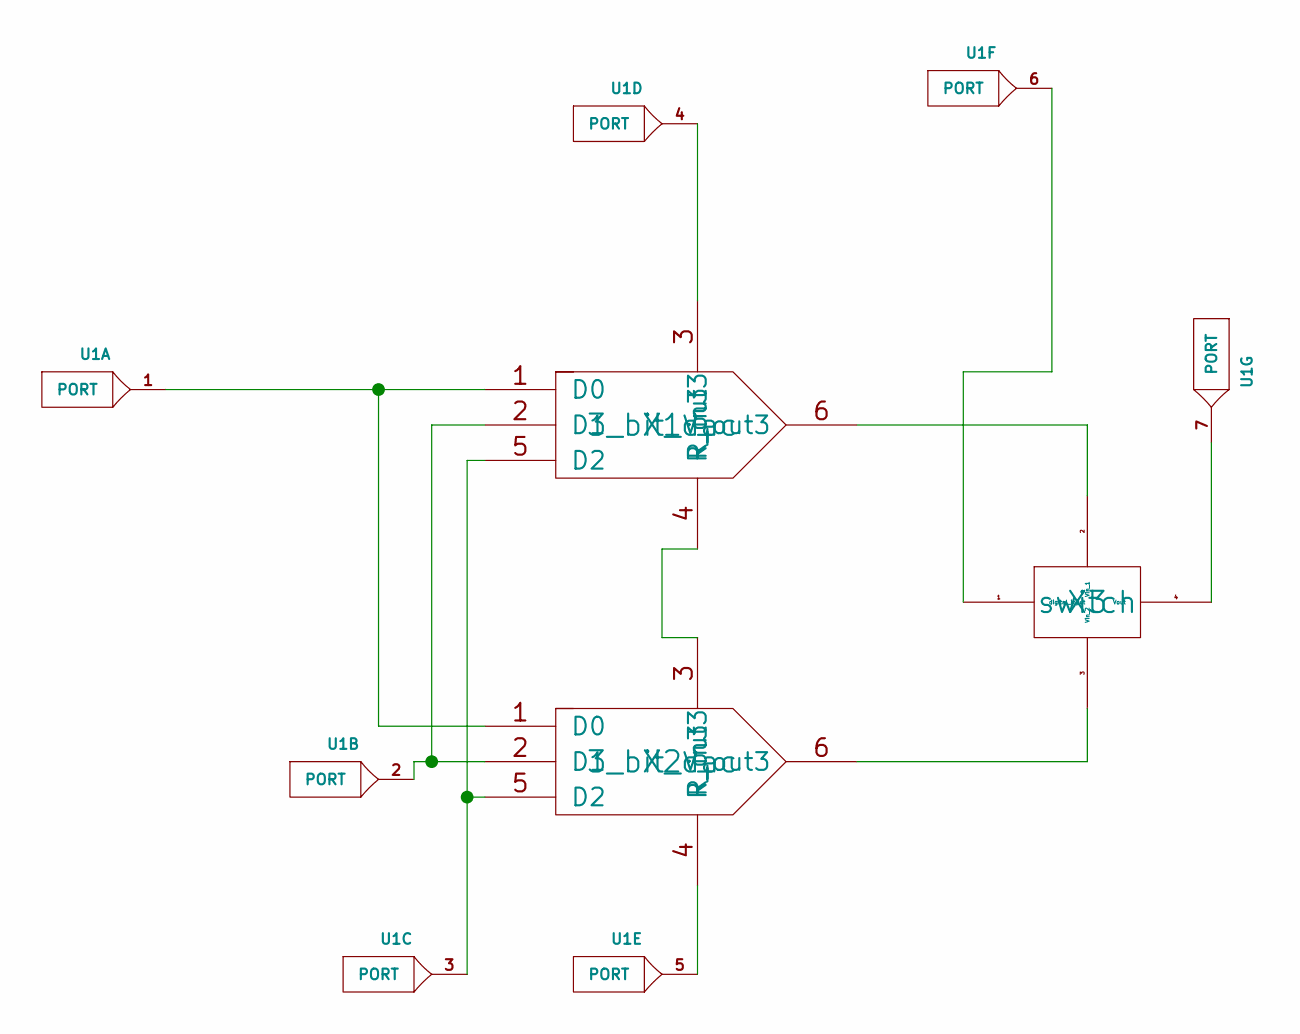
[picture p36: schematic 4_bit_dac.sch]

Parts:
U1: PORT
X1, X2: 3_bit_dac
X3: switch

Connections:
unnamed: U1.1, X1.1 (D0), X2.1 (D0)
unnamed: U1.2, X1.2 (D1), X2.2 (D1)
unnamed: U1.3, X1.5 (D2), X2.5 (D2)
unnamed: U1.4, X1.3 (R_in3)
unnamed: U1.5, X2.4 (R_out3)
unnamed: U1.6, X3.1 (digital_input)
unnamed: U1.7, X3.4 (Vout)
unnamed: X1.4 (R_out3), X2.3 (R_in3)
unnamed: X1.6 (V_out3), X3.2 (Vin_1)
unnamed: X2.6 (V_out3), X3.3 (Vin_2)
