xzlashutosh/avsddac_3v3/Pre-Layout and Simulation/5_bit_dac.sch

## KiCad design Pre-Layout and Simulation/5_bit_dac.sch (2020-08-22)

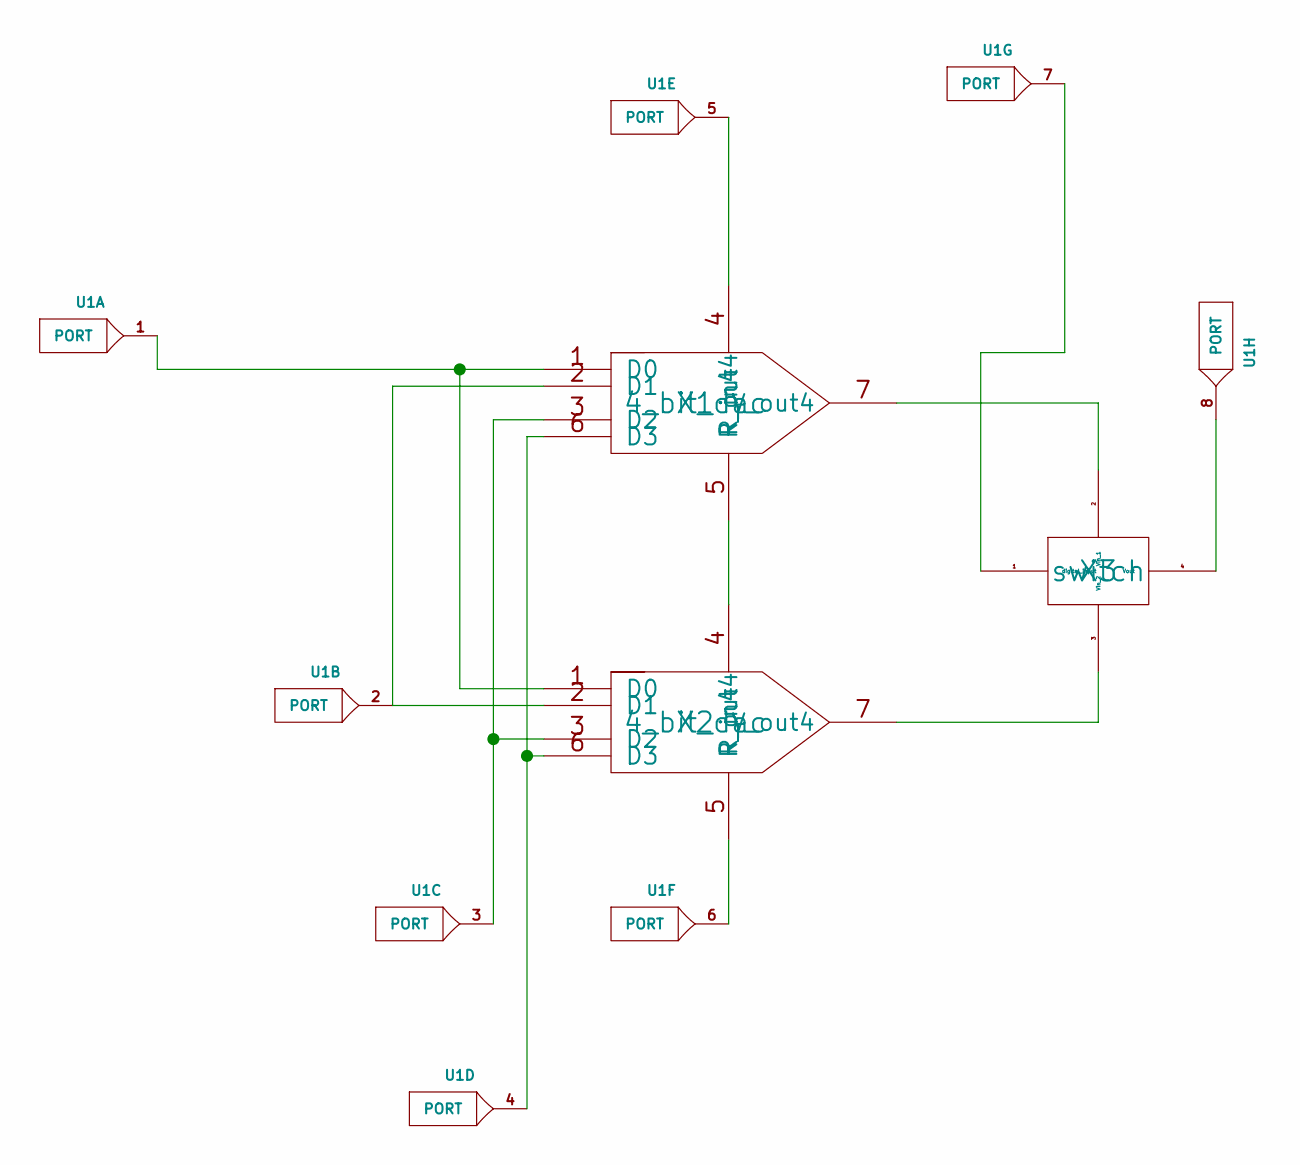
[picture p37: schematic 5_bit_dac.sch]

Parts:
U1: PORT
X1, X2: 4_bit_dac
X3: switch

Connections:
unnamed: U1.1, X1.1 (D0), X2.1 (D0)
unnamed: U1.2, X1.2 (D1), X2.2 (D1)
unnamed: U1.3, X1.3 (D2), X2.3 (D2)
unnamed: U1.4, X1.6 (D3), X2.6 (D3)
unnamed: U1.5, X1.4 (R_in4)
unnamed: U1.6, X2.5 (R_out4)
unnamed: U1.7, X3.1 (digital_input)
unnamed: U1.8, X3.4 (Vout)
unnamed: X1.5 (R_out4), X2.4 (R_in4)
unnamed: X1.7 (V_out4), X3.2 (Vin_1)
unnamed: X2.7 (V_out4), X3.3 (Vin_2)
