xzlashutosh/avsddac_3v3/Pre-Layout and Simulation/8_bit_dac.sch

## KiCad design Pre-Layout and Simulation/8_bit_dac.sch (2020-08-22)

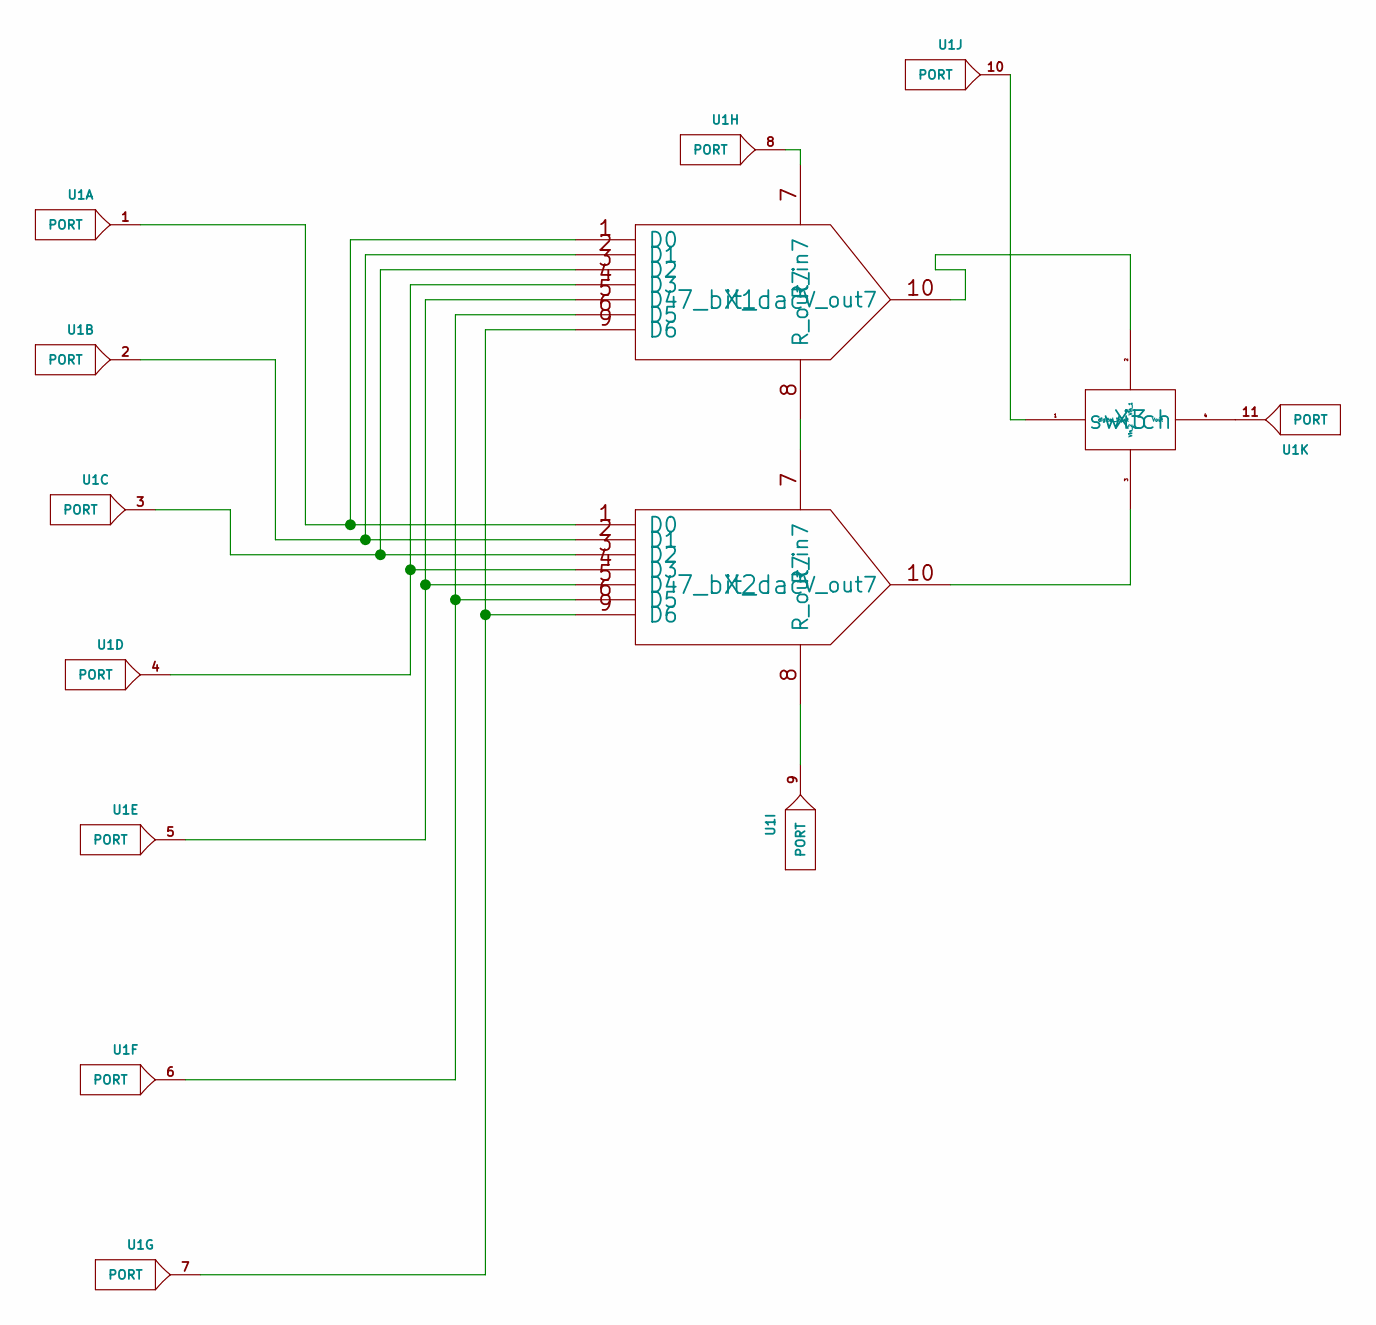
[picture p40: schematic 8_bit_dac.sch]

Parts:
U1: PORT
X1, X2: 7_bit_dac
X3: switch

Connections:
unnamed: U1.1, X1.1 (D0), X2.1 (D0)
unnamed: U1.2, X1.2 (D1), X2.2 (D1)
unnamed: U1.3, X1.3 (D2), X2.3 (D2)
unnamed: U1.4, X1.4 (D3), X2.4 (D3)
unnamed: U1.5, X1.5 (D4), X2.5 (D4)
unnamed: U1.6, X1.6 (D5), X2.6 (D5)
unnamed: U1.7, X1.9 (D6), X2.9 (D6)
unnamed: U1.8, X1.7 (R_in7)
unnamed: U1.9, X2.8 (R_out7)
unnamed: U1.10, X3.1 (digital_input)
unnamed: U1.11, X3.4 (Vout)
unnamed: X1.8 (R_out7), X2.7 (R_in7)
unnamed: X1.10 (V_out7), X3.2 (Vin_1)
unnamed: X2.10 (V_out7), X3.3 (Vin_2)
