xzlashutosh/avsddac_3v3/Pre-Layout and Simulation/10_bit_dac.sch

## KiCad design Pre-Layout and Simulation/10_bit_dac.sch (2020-09-03)

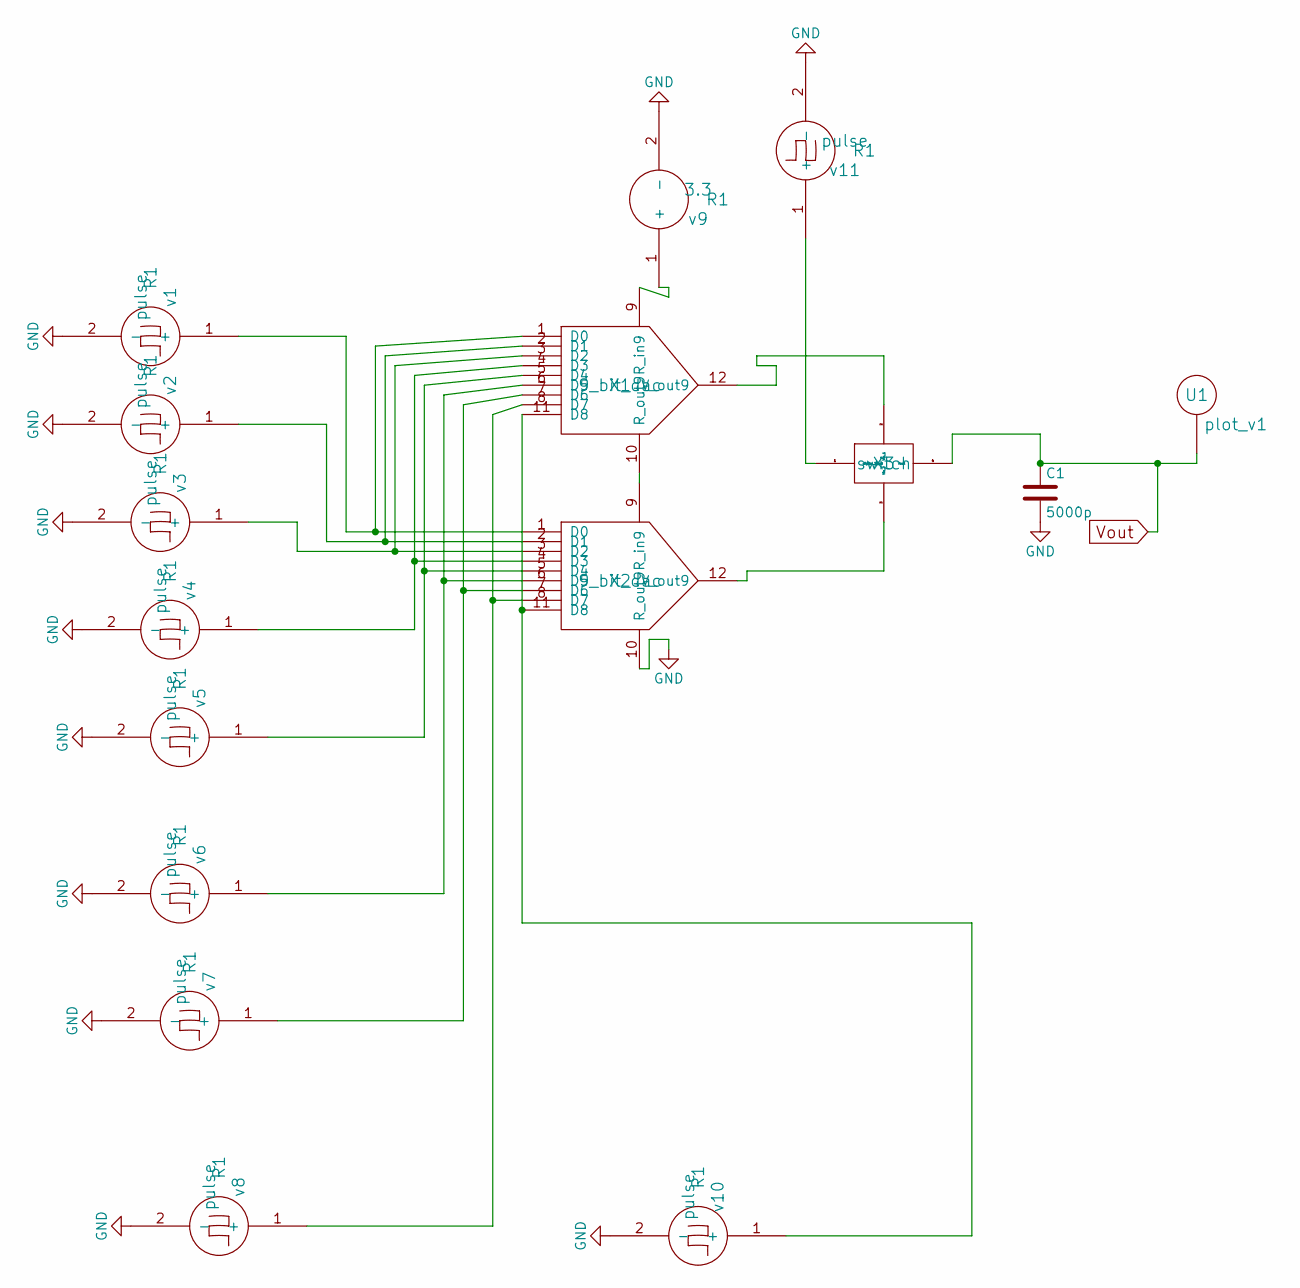
[picture p42: schematic 10_bit_dac.sch]

Parts:
C1: 5000p
U1: plot_v1
X1, X2: 9_bit_dac
X3: switch
v1, v2, v3, v4, v5, v6, v7, v8, v10, v11: pulse; R1
v9: 3.3; R1

Connections:
GND: C1.2, X2.10 (R_out9), v1.2 (-), v2.2 (-), v3.2 (-), v4.2 (-), v5.2 (-), v6.2 (-), v7.2 (-), v8.2 (-), v9.2 (-), v10.2 (-), v11.2 (-)
unnamed: X1.1 (D0), X2.1 (D0), v1.1 (+)
unnamed: X1.2 (D1), X2.2 (D1), v2.1 (+)
unnamed: X1.3 (D2), X2.3 (D2), v3.1 (+)
unnamed: X1.4 (D3), X2.4 (D3), v4.1 (+)
unnamed: X1.5 (D4), X2.5 (D4), v5.1 (+)
unnamed: X1.6 (D5), X2.6 (D5), v6.1 (+)
unnamed: X1.7 (D6), X2.7 (D6), v7.1 (+)
unnamed: X1.8 (D7), X2.8 (D7), v8.1 (+)
unnamed: X1.9 (R_in9), v9.1 (+)
unnamed: X1.10 (R_out9), X2.9 (R_in9)
unnamed: X1.11 (D8), X2.11 (D8), v10.1 (+)
unnamed: X1.12 (V_out9), X3.2 (Vin_1)
unnamed: X2.12 (V_out9), X3.3 (Vin_2)
unnamed: X3.1 (digital_input), v11.1 (+)
Vout: C1.1, U1.~, X3.4 (Vout)
