xzlashutosh/avsddac_3v3/Pre-Layout and Simulation/switch.sch

## KiCad design Pre-Layout and Simulation/switch.sch (2020-08-22)

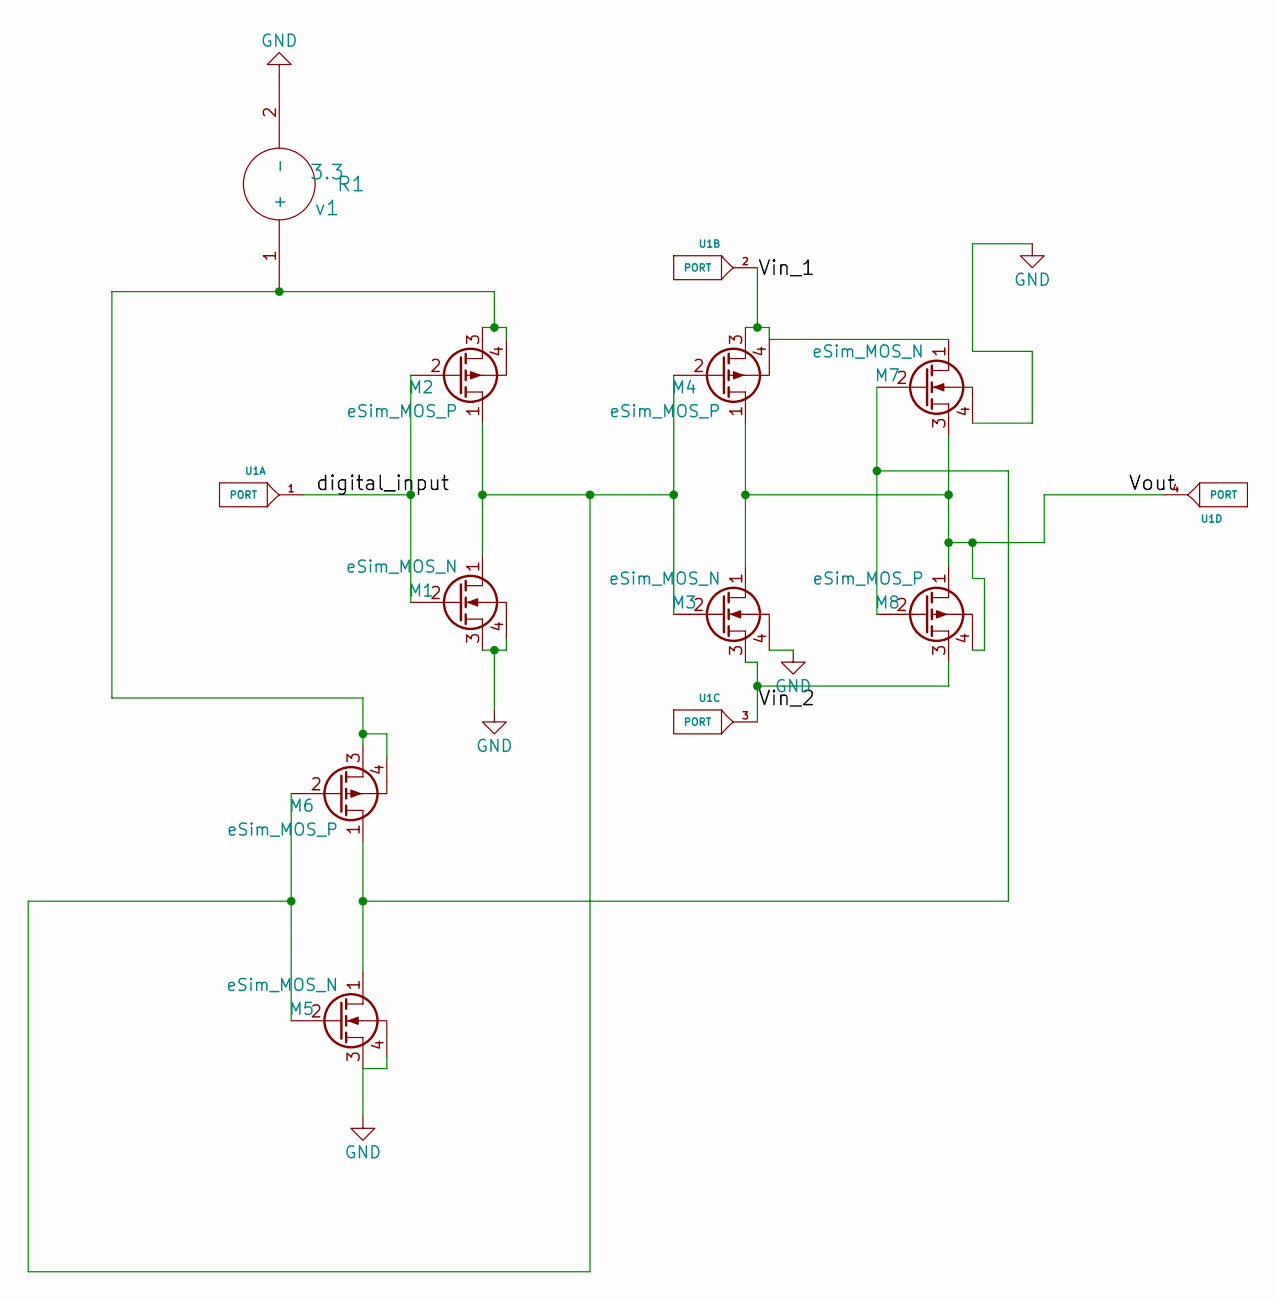
[picture p43: schematic switch.sch]

Parts:
M1, M3, M5, M7: eSim_MOS_N
M2, M4, M6, M8: eSim_MOS_P
U1: PORT
v1: 3.3; R1

Connections:
GND: M1.3 (S), M1.4 (B), M3.4 (B), M5.3 (S), M5.4 (B), M7.4 (B), v1.2 (-)
unnamed: M1.1 (D), M2.1 (D), M3.2 (G), M4.2 (G), M5.2 (G), M6.2 (G)
unnamed: M2.3 (S), M2.4 (B), M6.3 (S), M6.4 (B), v1.1 (+)
unnamed: M5.1 (D), M6.1 (D), M7.2 (G), M8.2 (G)
Vin_1: M4.3 (S), M4.4 (B), M7.1 (D), U1.2
Vin_2: M3.3 (S), M8.3 (S), U1.3
Vout: M3.1 (D), M4.1 (D), M7.3 (S), M8.1 (D), M8.4 (B), U1.4
digital_input: M1.2 (G), M2.2 (G), U1.1
