xzlashutosh/avsddac_3v3/(commit log)

2020-08-22 Deleted 4T Files
    [10_bit_dac.sch, 2_bit_dac.sch, 3_bit_dac.sch, 4_bit_dac.sch, 5_bit_dac.sch, 6_bit_dac.sch, 7_bit_dac.sch, 8_bit_dac.sch]
2020-08-22 Subcircuits for best switch
    [2_bit_dac.sch, 3_bit_dac.sch, 4_bit_dac.sch, 5_bit_dac.sch, 6_bit_dac.sch, 7_bit_dac.sch, 8_bit_dac.sch, 9_bit_dac.sch]
